ig0rb/ESP32-EVSE/README.md

# ESP32-EVSE

This is an alpha version, it's work, but need more work the satisfy all safety requirements of J1772 standard.

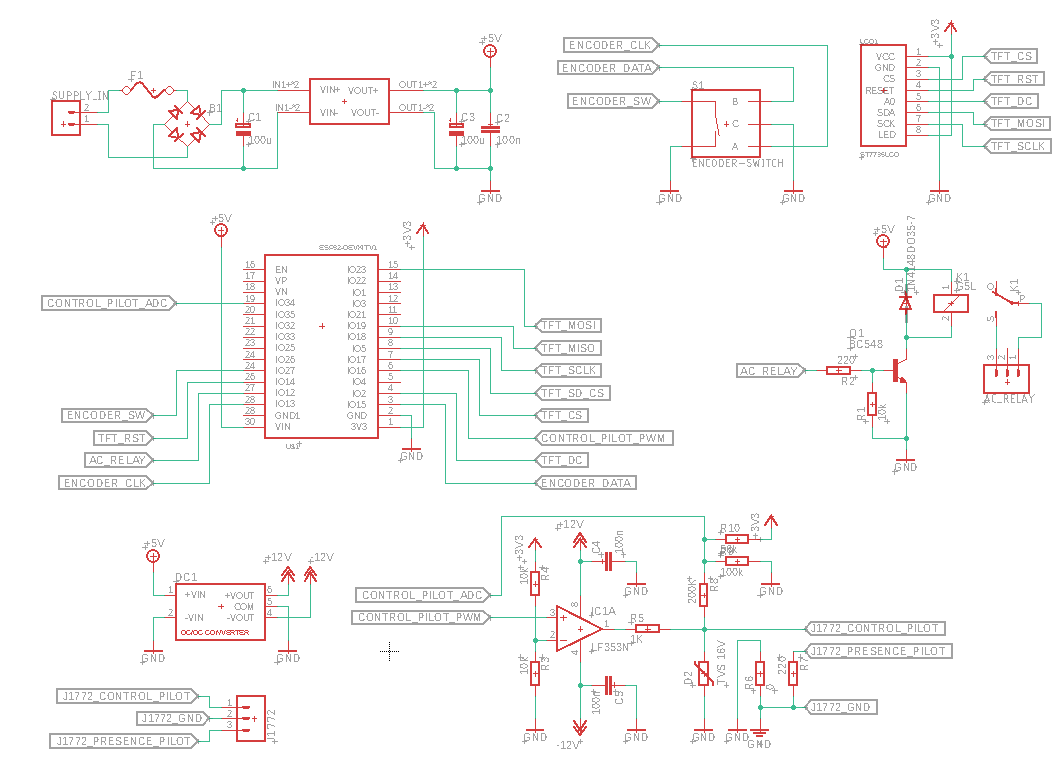
[picture p1: docs/schema elettrico.png]
schematic
