ig0rb/ESP32-EVSE/data/eco-friendly.png

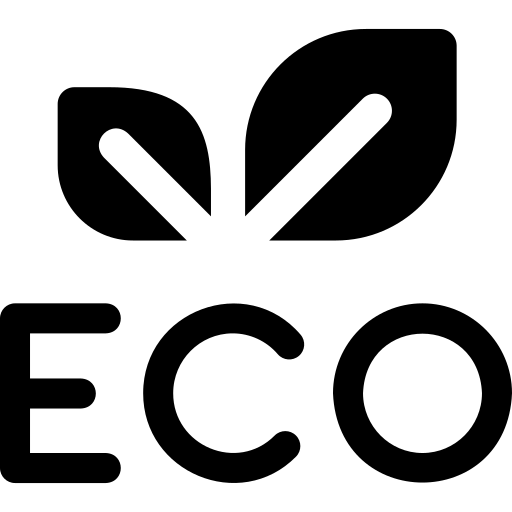
data/eco-friendly.png
