ig0rb/ESP32-EVSE/data/solar-panel.png

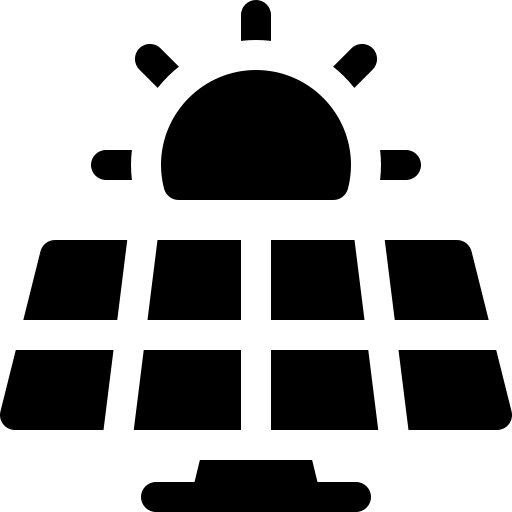
data/solar-panel.png
