ig0rb/ESP32-EVSE/data/space-rocket-launch.png

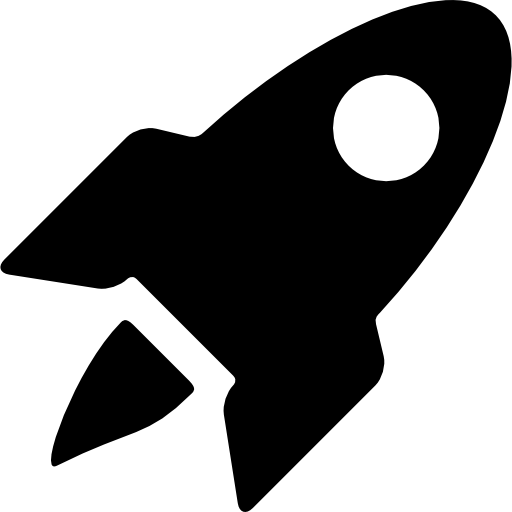
data/space-rocket-launch.png
