ig0rb/ESP32-EVSE/data/turtle.png

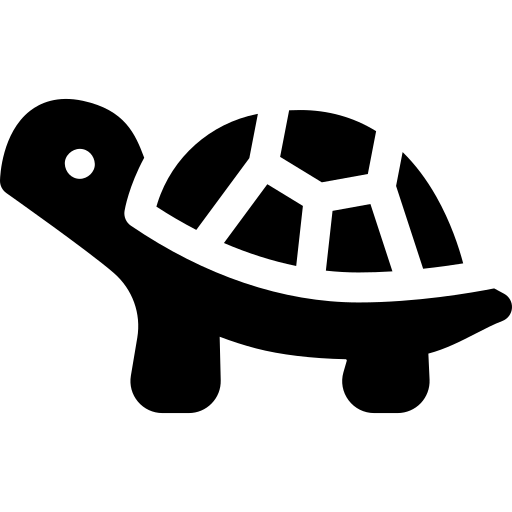
data/turtle.png
