ig0rb/ESP32-EVSE/docs/config evse settings.png

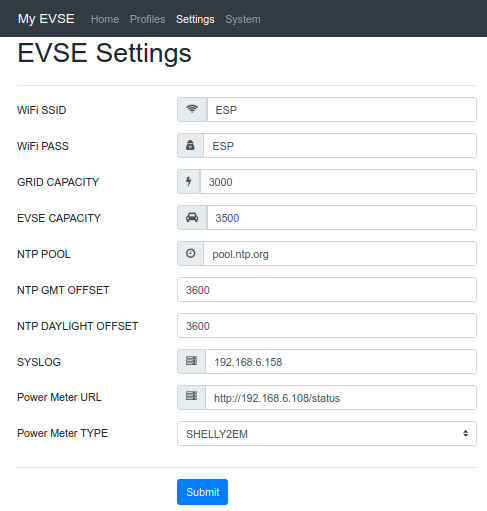
docs/config evse settings.png
