ig0rb/ESP32-EVSE/docs/SHELLY SCHEMA COLLEGAMENTO.png

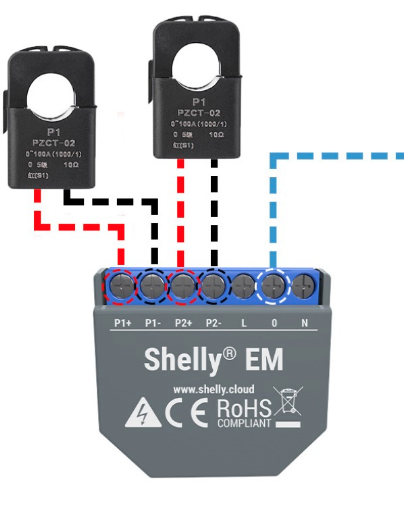
docs/SHELLY SCHEMA COLLEGAMENTO.png
