ig0rb/ESP32-EVSE/docs/SHELLY WEB PANEL.png

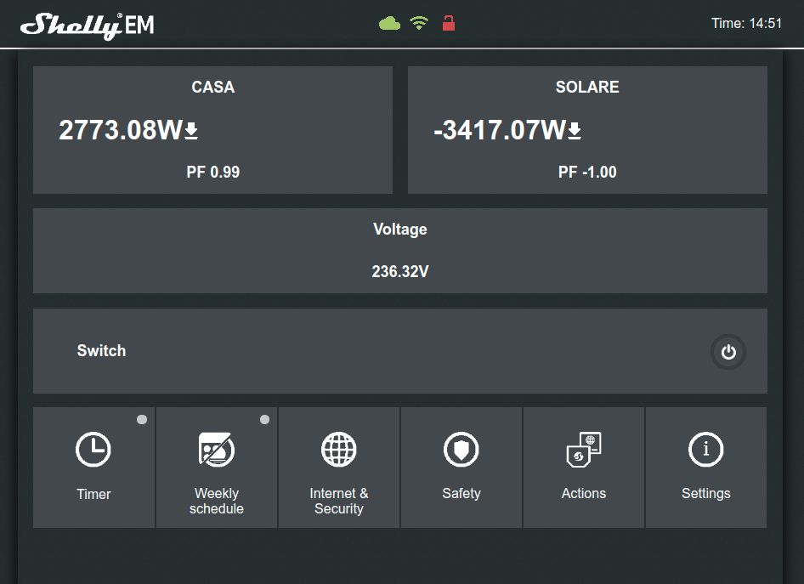
docs/SHELLY WEB PANEL.png
