ig0rb/ESP32-EVSE/docs/ui_mobile.jpeg

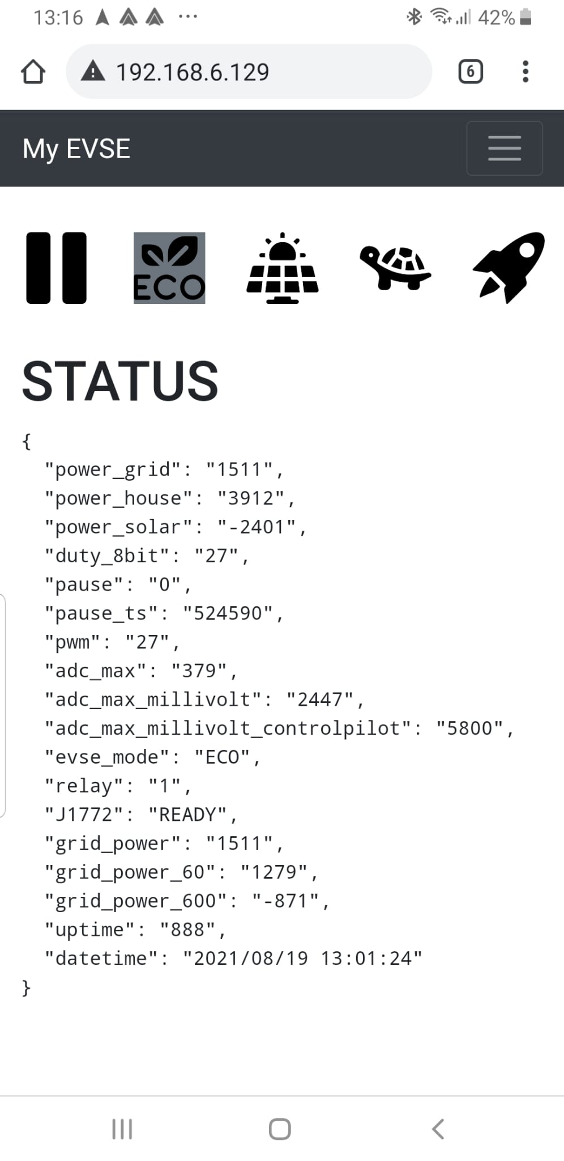
docs/ui_mobile.jpeg
