ig0rb/ESP32-EVSE/(threads)

Thread 1 (2022-01-10):

Sviluppo futuro

pad52, 2022-01-10:
Ciao e complimenti per il progetto. Mi piacerebbe aiutarti a implementare gli sviluppi futuri. Ne parliamo?

ig0rb, 2022-05-05:
Ciao, scusa il ritardo nella risposta, cmq si ci sarebbero tante cose da aggiungere volendo, alcune relative alla sicurezza :)

Cmq lo sto usando da un bel po' e funziona alla grande, tranne da ottobre a febbraio, dove c'e' poco solo il resto dell'anno carico sempre la macchina gratis :)
