ig0rb/ESP32-EVSE/docs/ESP32 EVSE.sch

## EAGLE design docs/ESP32 EVSE.sch (2021-08-24)

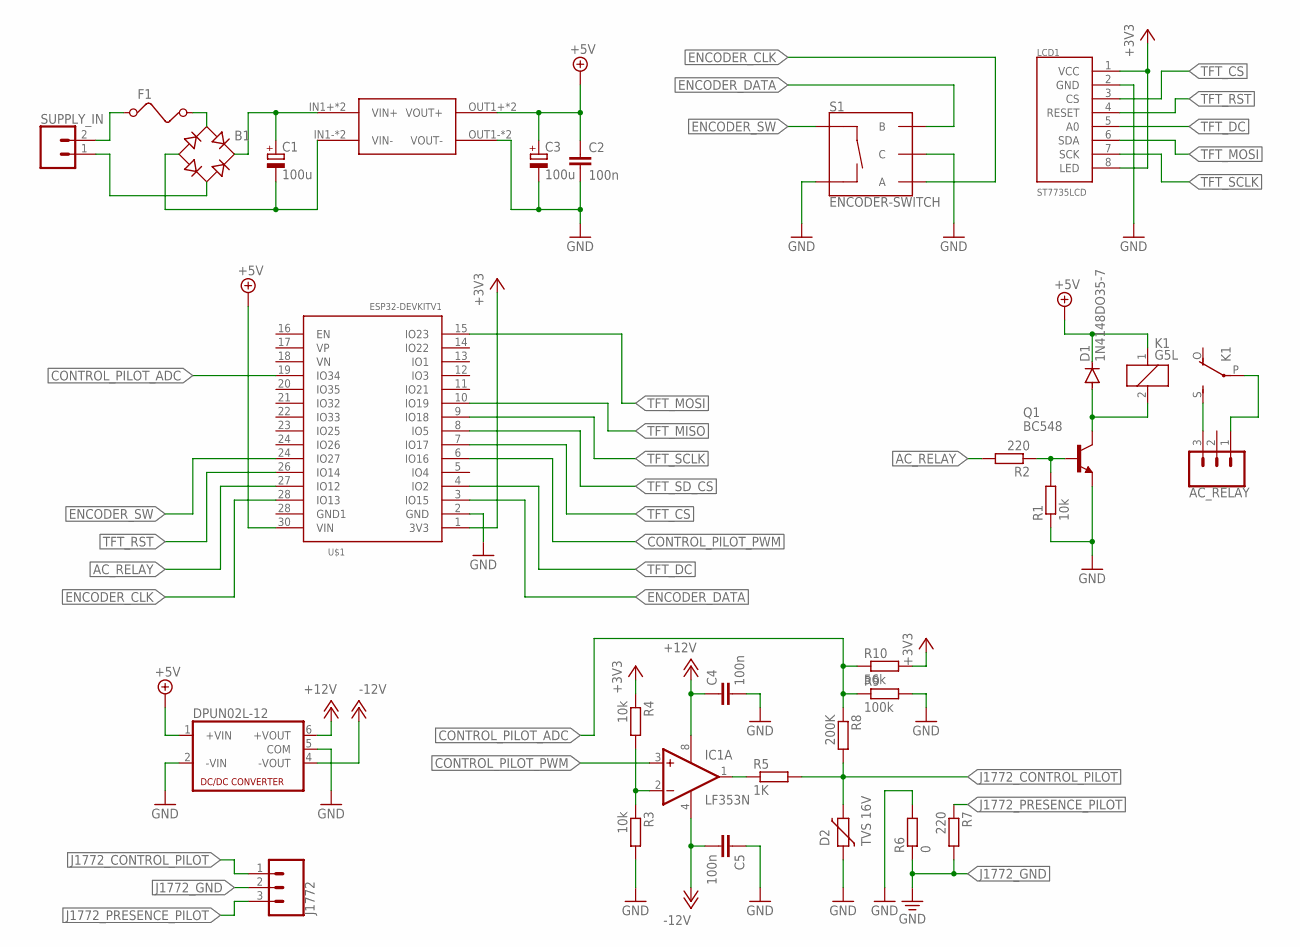
[picture p20: schematic ESP32 EVSE.sch]

Parts:
AC_RELAY: CONN_03SCREW; SCREWTERMINAL-3.5MM-3
B1: B-DIL
C1, C3: 100u; E2-5
C2, C4, C5: 100n; C050-024X044
D1: 1N4148DO35-7; DO35-7
D2: TVS 16V; DIOM5226X290N
DPUN02L-12: NMA
F1: FUSE
IC1: LF353N; DIL08
J1772: CONN_03SCREW; SCREWTERMINAL-3.5MM-3
K1: G5L; G5LE
LCD1: ST7735LCD
Q1: BC548; TO92-EBC
R1, R3, R4: 10k; 0204/5
R2, R7: 220; 0204/5
R5: 1K; 0204/5
R6: 0; 0204/5
R8: 200K; 0204/5
R9: 100k; 0204/5
R10: 56k; 0204/5
S1: ENCODER-SWITCH; ROTARY_ENC_PLAIN
SUPPLY_IN: CONN_023.5MM-NO_SILK; SCREWTERMINAL-3.5MM-2-NS
U$1: ESP32DEVKITV1; ESP32-DEVKITV1
U$2: MP1584; DC-BRICK

Connections:
+3V3: LCD1.1 (VCC), LCD1.8 (LED), R4.1, R10.2, U$1.1 (3V3)
+5V: C2.1, C3.+, D1.C, DPUN02L-12.1 (+VIN), K1.1, U$1.30 (VIN), U$2.OUT1+ (VOUT+)
+12V: C4.1, DPUN02L-12.6 (+VOUT), IC1.8 (V+)
-12V: C5.2, DPUN02L-12.4 (-VOUT), IC1.4 (V-)
AC_RELAY: R2.2, U$1.27 (IO12)
CONTROL_PILOT_ADC: R8.1, R9.1, R10.1, U$1.19 (IO34)
CONTROL_PILOT_PWM: IC1.3 (+IN), U$1.6 (IO16)
ENCODER_CLK: S1.A, U$1.28 (IO13)
ENCODER_DATA: S1.B, U$1.3 (IO15)
ENCODER_SW: S1.SW+, U$1.24 (IO27)
GND: C2.2, C3.-, C4.2, C5.1, D2.1, DPUN02L-12.2 (-VIN), DPUN02L-12.5 (COM), LCD1.2 (GND), Q1.E, R1.1, R6.2, R9.2, S1.C, S1.SW-, U$1.2 (GND), U$2.OUT1- (VOUT-)
J1772_CONTROL_PILOT: D2.2, J1772.1, R5.2, R8.2
J1772_GND: J1772.2, R6.1, R7.2
J1772_PRESENCE_PILOT: J1772.3, R7.1
unnamed: F1.1, SUPPLY_IN.2
unnamed: B1.AC2, SUPPLY_IN.1
unnamed: B1.AC1, F1.2
unnamed: B1.-, C1.-, U$2.IN1- (VIN-)
unnamed: B1.+, C1.+, U$2.IN1+ (VIN+)
unnamed: AC_RELAY.3, K1.S
unnamed: AC_RELAY.1, K1.P
unnamed: D1.A, K1.2, Q1.C
unnamed: Q1.B, R1.2, R2.1
unnamed: IC1.2 (-IN), R3.1, R4.2
unnamed: IC1.1 (OUT), R5.1
TFT_CS: LCD1.3 (CS), U$1.7 (IO17)
TFT_DC: LCD1.5 (A0), U$1.4 (IO2)
TFT_MISO: U$1.10 (IO19)
TFT_MOSI: LCD1.6 (SDA), U$1.15 (IO23)
TFT_RST: LCD1.4 (RESET), U$1.26 (IO14)
TFT_SCLK: LCD1.7 (SCK), U$1.9 (IO18)
TFT_SD_CS: U$1.8 (IO5)
