ig0rb/ESP32-EVSE/include/icons.h

#ifndef _EVSE_ICONS_H_
#define _EVSE_ICONS_H_

// 'hourglass-start-49-64', 49x64px
const unsigned char icon_hourglass_start_49_64 [] PROGMEM = {
	0xff, 0xff, 0xff, 0xff, 0xff, 0xff, 0x00, 0xff, 0xff, 0xff, 0xff, 0xff, 0xff, 0x00, 0xff, 0xff, 
	0xff, 0xff, 0xff, 0xff, 0x00, 0xff, 0xff, 0xff, 0xff, 0xff, 0xff, 0x00, 0x3c, 0x00, 0x00, 0x00, 
	0x00, 0x3c, 0x00, 0x3c, 0x00, 0x00, 0x00, 0x00, 0x3c, 0x00, 0x3c, 0x00, 0x00, 0x00, 0x00, 0x3c, 
	0x00, 0x3c, 0x00, 0x00, 0x00, 0x00, 0x3c, 0x00, 0x3c, 0x1f, 0xff, 0xff, 0xf8, 0x3c, 0x00, 0x3e, 
	0x3f, 0xff, 0xff, 0xfc, 0x7c, 0x00, 0x1e, 0x1f, 0xff, 0xff, 0xf8, 0x78, 0x00, 0x1e, 0x1f, 0xff, 
	0xff, 0xf8, 0x78, 0x00, 0x1e, 0x00, 0x00, 0x00, 0x00, 0x78, 0x00, 0x1e, 0x00, 0x00, 0x00, 0x00, 
	0x78, 0x00, 0x0f, 0x00, 0x00, 0x00, 0x00, 0xf0, 0x00, 0x0f, 0x00, 0x00, 0x00, 0x00, 0xf0, 0x00, 
	0x0f, 0x03, 0xff, 0xff, 0xc0, 0xf0, 0x00, 0x07, 0x83, 0xff, 0xff, 0xc1, 0xe0, 0x00, 0x07, 0x83, 
	0xff, 0xff, 0xc1, 0xe0, 0x00, 0x07, 0xc1, 0xff, 0xff, 0x83, 0xe0, 0x00, 0x03, 0xe0, 0x00, 0x00, 
	0x07, 0xc0, 0x00, 0x03, 0xe0, 0x00, 0x00, 0x07, 0xc0, 0x00, 0x01, 0xf0, 0x00, 0x00, 0x0f, 0x80, 
	0x00, 0x00, 0xf8, 0x00, 0x00, 0x1f, 0x00, 0x00, 0x00, 0xfc, 0x00, 0x00, 0x3f, 0x00, 0x00, 0x00, 
	0x7e, 0x00, 0x00, 0x7e, 0x00, 0x00, 0x00, 0x3f, 0x00, 0x00, 0xfc, 0x00, 0x00, 0x00, 0x1f, 0xc0, 
	0x03, 0xf8, 0x00, 0x00, 0x00, 0x0f, 0xf8, 0x1f, 0xf0, 0x00, 0x00, 0x00, 0x03, 0xff, 0xff, 0xc0, 
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
};

// Array of all bitmaps for convenience. (Total bytes used to store images in PROGMEM = 464)
/*
const int icon_allArray_LEN = 1;
const unsigned char* icon_allArray[1] = {
	icon_hourglass_start_49_64
};
*/
#endif
