ig0rb/ESP32-EVSE/include/EVSE.h

#ifndef _H_EVSE_H_
#define _H_EVSE_H_




/*
//#include <SPI.h>
//#include <Wire.h>
//#include <Adafruit_GFX.h>
//#include <Adafruit_SSD1306.h>
//#include <SimpleButton.h>
#include <Arduino.h>
//#include <TFT_eSPI.h>
#include <ESPAsyncWebServer.h>
#include <WiFi.h>
#include <HTTPClient.h>
#include <ArduinoJson.h>
#include <AsyncJson.h>

#include <ESPmDNS.h>
#include <WiFiUdp.h>
#include <ArduinoOTA.h>
#include <icons.h>
#include <Config.h>
#include <Status.h>
#include <Networking.h>
#include <UI.h>
#include <J1772.h>
#include <PowerMonitor.h>
#include <PowerManager.h>
#include <OTA.h>
#include <WebServer.h>
#include <FS.h>
#include <SPIFFS.h>
#include <SPIFFSEditor.h>
#include <Preferences.h>
#include <time.h>
*/

#endif
