ig0rb/ESP32-EVSE/src/OTA.cpp

//#include <EVSE.h>

#include "OTA.h"

namespace EVSE {
    OTA::OTA() {

    }

    void OTA::handle() {
        arduinoOTA.handle();
    }

  void OTA::begin() {
      arduinoOTA.setHostname(WiFi.getHostname());
      arduinoOTA.onStart([](){
        String type;
        if (ArduinoOTA.getCommand() == U_FLASH) {
            type = "sketch";
        } else { // U_SPIFFS
            type = "filesystem";
        }

        // NOTE: if updating SPIFFS this would be the place to unmount SPIFFS using SPIFFS.end()
        Serial.println("Start updating " + type);
      });

      arduinoOTA.onEnd([](){
          Serial.println("\nEnd");
      });

    arduinoOTA.onProgress([](unsigned int progress, unsigned int total) {
      Serial.printf("Progress: %u%%\r", (progress / (total / 100)));
    });

    arduinoOTA.onError([](ota_error_t error) {
      Serial.printf("Error[%u]: ", error);
      if (error == OTA_AUTH_ERROR) Serial.println("Auth Failed");
      else if (error == OTA_BEGIN_ERROR) Serial.println("Begin Failed");
      else if (error == OTA_CONNECT_ERROR) Serial.println("Connect Failed");
      else if (error == OTA_RECEIVE_ERROR) Serial.println("Receive Failed");
      else if (error == OTA_END_ERROR) Serial.println("End Failed");
    });

    arduinoOTA.begin();



  }

}
